technoblogy/five-leds-puzzle/README.md

# Five LEDs Puzzle
A puzzle based on an ATtiny85 in which you have to press the buttons in the right sequence to light up all the LEDs.

For more information see: <http://www.technoblogy.com/show?3EL5>.
