technoblogy/five-leds-puzzle/Eagle files/FiveLEDsPuzzle.brd

## EAGLE design Eagle files/FiveLEDsPuzzle.brd (2021-01-04)

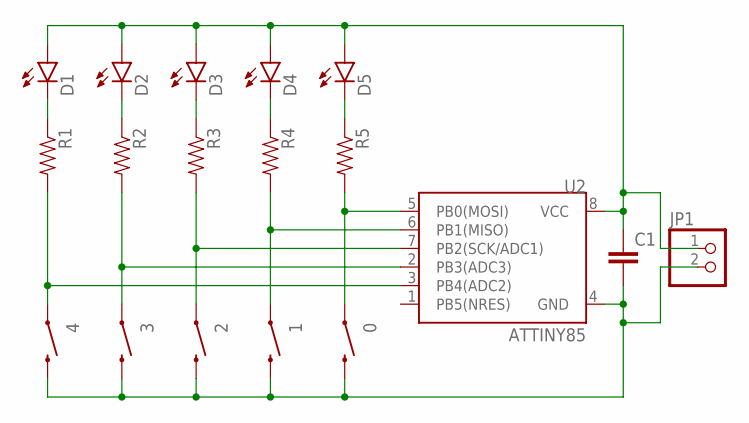
[picture p1: schematic FiveLEDsPuzzle.sch]

Parts:
0, 1, 2, 3, 4: SWITCH-MOMENTARY-2PTH; TACTILE-PTH
C1: 0.1UF-50V-20%(PTH)KIT-EZ; CAP-PTH-SMALL-KIT
D1, D2, D3, D4, D5: LED5MM
JP1: HEADER-1X2ROUND; 1X02_ROUND
R1, R2, R3, R4, R5: RESISTORAXIAL-0.3; AXIAL-0.3
U2: ATTINY85; DIP08

Connections:
unnamed: 3.1, R2.P$2 (2), U2.2 (PB3(ADC3))
unnamed: D2.K (C), R2.P$1 (1)
unnamed: 2.1, R3.P$2 (2), U2.7 (PB2(SCK/ADC1))
unnamed: D3.K (C), R3.P$1 (1)
unnamed: 4.1, R1.P$2 (2), U2.3 (PB4(ADC2))
unnamed: 1.1, R4.P$2 (2), U2.6 (PB1(MISO))
unnamed: D4.K (C), R4.P$1 (1)
unnamed: C1.1, D1.A, D2.A, D3.A, D4.A, D5.A, JP1.1, U2.8 (VCC)
unnamed: D5.K (C), R5.P$1 (1)
unnamed: 0.1, R5.P$2 (2), U2.5 (PB0(MOSI))
unnamed: 0.3 (2), 1.3 (2), 2.3 (2), 3.3 (2), 4.3 (2), C1.2, JP1.2, U2.4 (GND)
unnamed: D1.K (C), R1.P$1 (1)

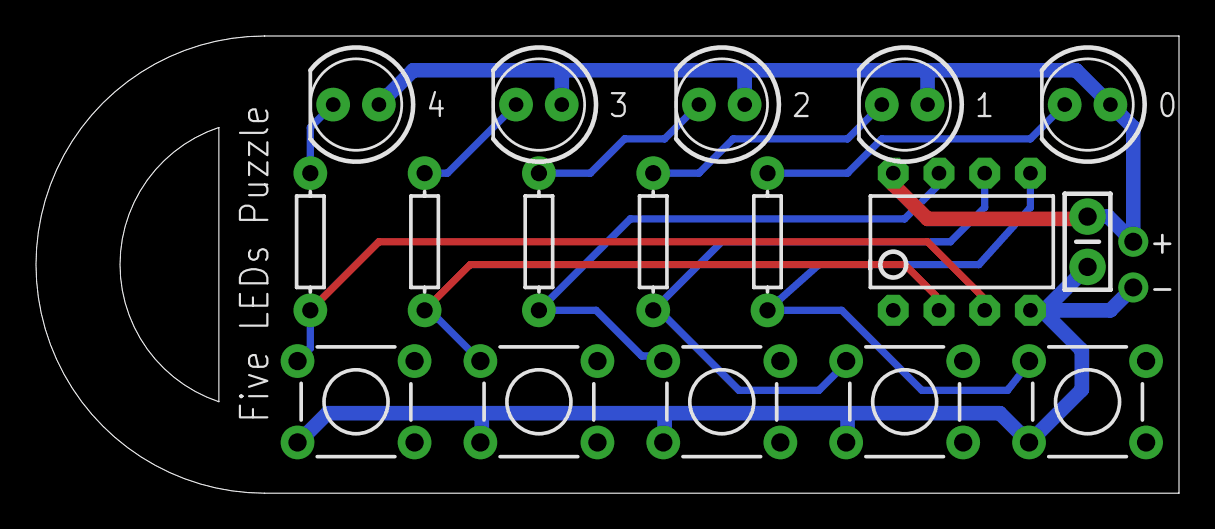
[picture p2: board FiveLEDsPuzzle.brd from above]

Board: 2 copper layers, 63.5 x 25.4 mm, 18 parts (0 on the bottom side), 12 nets.
