technoblogy/five-leds-puzzle/(threads)

Thread 1 (2021-01-05):

Operator precedence: Wait for button release does not work as intended

JChristensen, 2021-01-05:
https://github.com/technoblogy/five-leds-puzzle/blob/b1b3ee8016ac978b866e31141f930374b91f43bf/FiveLEDsPuzzle.ino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
Should be:
```c++
  while ((PINB & 0x1F) != 0x1F);      // Wait for all buttons released
```
Cool project, clever code! I may adapt it for a surface-mount ATtiny84A, should be straightforward.

technoblogy, 2021-01-05:
Thanks! Corrected.

technoblogy, 2021-01-05:
PS On an ATtiny84 you could extend it to have up to eight buttons and LEDs, using PA0 to PA7, to make a harder puzzle!

Closed 2021-01-05.
