technoblogy/five-leds-puzzle/(commit log)

2021-01-04 Version 1 - 4th January 2021
    [FiveLEDsPuzzle.brd, FiveLEDsPuzzle.sch]
2021-01-05 Version 3 - 5th January 2021
    Fixes #1: Correction to debounce when coming out of sleep.
    [FiveLEDsPuzzle.ino]
2021-01-09 Pullups on to read switches.
2021-01-09 Version 4 - 9th January 2021
    Added code to turn on the pullup resistor when reading an input for more reliable operation as the battery voltage decreases.
